friedertonn/AC1-Tastatur/(commit log)

2022-01-03 Arduino Nano
2022-01-21 #define LED_statt_Joystick
